M-DAS/MDAS-Drive_by_Wire/README.md

# MDAS-Drive_by_Wire
The drive-by-wire division of the University of Michigan-Dearborn Autonomous Shuttle.
