M-DAS/MDAS-Drive_by_Wire/PCB/v2.0/MDAS_Controller_V2.pdf

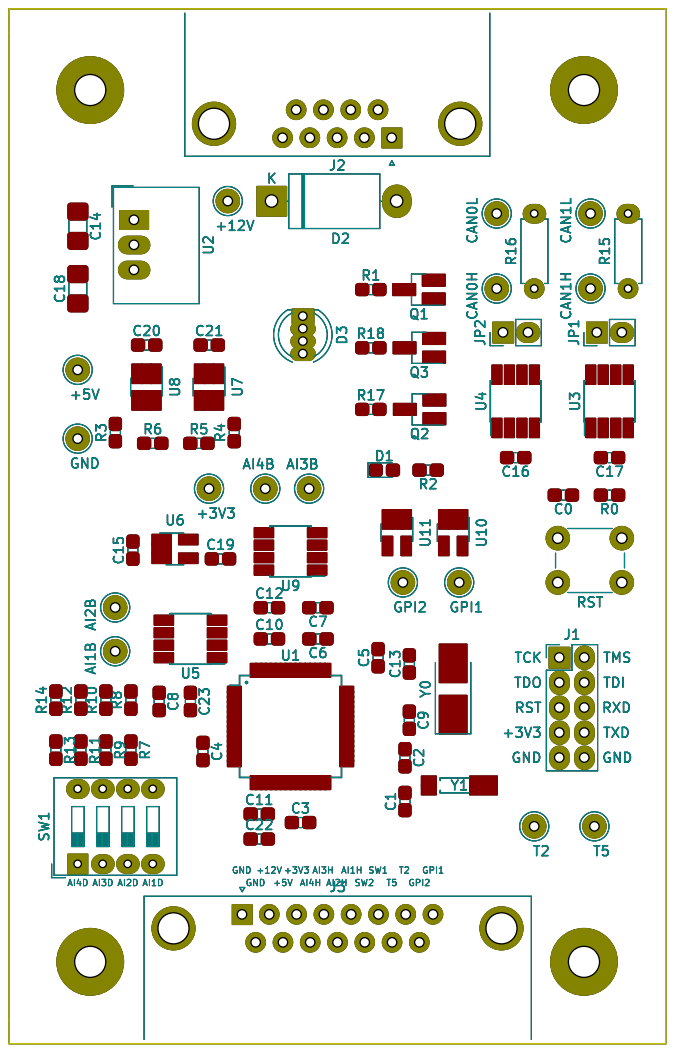
[picture p1: page 1]
