M-DAS/MDAS-Drive_by_Wire/PCB/v2.0/MDAS_Controller_V2.kicad_pcb

## KiCad design PCB/v2.0/MDAS_Controller_V2.kicad_pcb (2018-09-26)

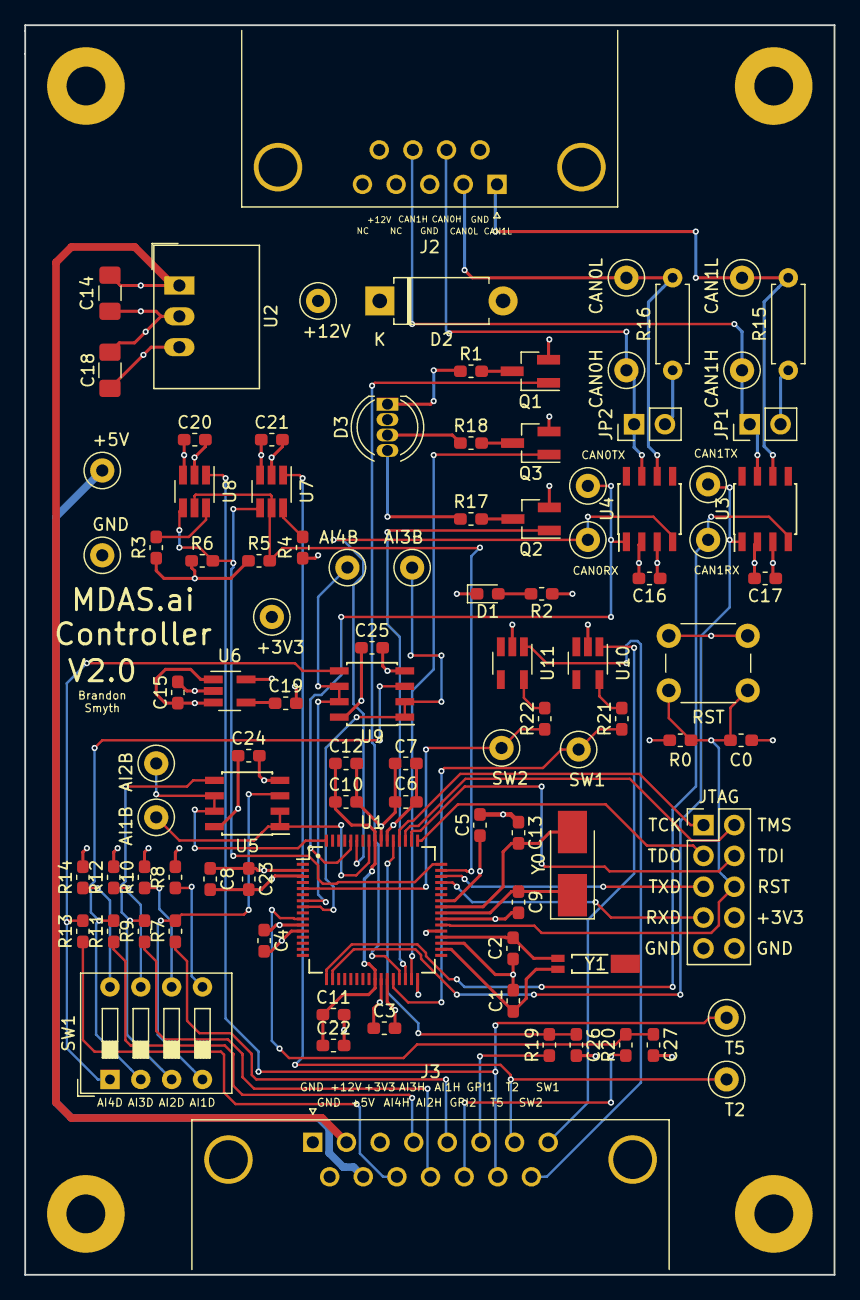
[picture p2: board MDAS_Controller_V2.kicad_pcb from above]

Board: 4 copper layers, 66.7 x 102.9 mm, 101 parts (0 on the bottom side), 69 nets.

Parts:
+3V3, +5V, +12V: TestPoint; TestPoint_Loop_D1.80mm_Drill1.0mm_Beaded
AI1B, AI2B, AI3B, AI4B: TestPoint; TestPoint_Loop_D1.80mm_Drill1.0mm_Beaded
C0, C3, C4, C5, C6, C10, C11, C16, C17, C20, C21, C24, C25: 0.1uF; C_0603_1608Metric_Pad1.05x0.95mm_HandSolder
C1, C2: 24pF; C_0603_1608Metric_Pad1.05x0.95mm_HandSolder
C7, C22: 2.2uF; C_0603_1608Metric_Pad1.05x0.95mm_HandSolder
C8, C12, C15: 1.0uF; C_0603_1608Metric_Pad1.05x0.95mm_HandSolder
C9, C13: 10pF; C_0603_1608Metric_Pad1.05x0.95mm_HandSolder
C14, C18: 10uF; C_1206_3216Metric_Pad1.42x1.75mm_HandSolder
C19, C23, C26, C27: 0.01uF; C_0603_1608Metric_Pad1.05x0.95mm_HandSolder
CAN0H, CAN0L, CAN0RX, CAN0TX, CAN1H, CAN1L, CAN1RX, CAN1TX: TestPoint; TestPoint_Loop_D1.80mm_Drill1.0mm_Beaded
D1: LED; LED_0603_1608Metric_Pad1.05x0.95mm_HandSolder
D2: TP6KE33A; D_DO-15_P10.16mm_Horizontal
D3: LED_RABG; LED_D5.0mm-4
GND: TestPoint; TestPoint_Loop_D1.80mm_Drill1.0mm_Beaded
J2: DB9_Male; DSUB-9_Male_Horizontal_P2.77x2.84mm_EdgePinOffset9.90mm_Hou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
J3: DB15_Male; DSUB-15_Male_Horizontal_P2.77x2.84mm_EdgePinOffset7.70mm_Ho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
JP1, JP2: Jumper_NC_Small; PinHeader_1x02_P2.54mm_Vertical
JTAG: JTAG; PinHeader_2x05_P2.54mm_Vertical
MH1, MH2, MH3, MH4: MountingHole_Pad; MountingHole_3.2mm_M3_Pad
Q1, Q2, Q3: DTC114E; SOT-23_Handsoldering
R0, R3, R4, R5, R6: 10k; R_0603_1608Metric_Pad1.05x0.95mm_HandSolder
R1, R2, R17, R18: 330; R_0603_1608Metric_Pad1.05x0.95mm_HandSolder
R7, R9, R11, R13: 11k; R_0603_1608Metric_Pad1.05x0.95mm_HandSolder
R8, R10, R12, R14: 21k; R_0603_1608Metric_Pad1.05x0.95mm_HandSolder
R15, R16: 120; R_Axial_DIN0207_L6.3mm_D2.5mm_P7.62mm_Horizontal
R19, R20, R21, R22: 1k; R_0603_1608Metric_Pad1.05x0.95mm_HandSolder
RST: SW_Push; SW_PUSH_6mm_H5mm
SW1: SW_DIP_x04; SW_DIP_SPSTx04_Slide_9.78x12.34mm_W7.62mm_P2.54mm
SW1#2, SW2: TestPoint; TestPoint_Loop_D1.80mm_Drill1.0mm_Beaded
T2, T5: TestPoint; TestPoint_Loop_D1.80mm_Drill1.0mm_Beaded
U1: TM4C123GH6PM; LQFP-64_10x10mm_P0.5mm
U2: R-78E5.0-0.5; Converter_DCDC_RECOM_R-78E-0.5_THT
U3, U4: SN65HVD232; SOIC-8_3.9x4.9mm_P1.27mm
U5, U9: OPA2333xxD; SOIC-8_3.9x4.9mm_P1.27mm
U6: TPS73633DBV; SOT-23-5_HandSoldering
U7, U8: MCP4725A2T-E_CH; SOT-23-6_Handsoldering
U10, U11: TPS70933DBVT; SOT-23-5_HandSoldering
Y0: 16MHz; Crystal_SMD_5032-2Pin_5.0x3.2mm_HandSoldering
Y1: 32.768kHz; ABRACON_AB26TRQ

Connections:
+3V3: +3V3.1, C3.1, C4.1, C5.1, C6.1, C7.1, C8.1, C16.1, C17.1, C23.1, C24.1, C25.1, J3.3, JTAG.8, R0.1, R2.1, U1.2, U1.11, U1.26, U1.37, U1.42, U1.54, U3.3, U4.3, U5.8, U6.5, U9.8
+5V: +5V.1, C15.1, C18.1, C20.1, C21.1, D3.2, J3.10, R3.1, R5.1, R6.1, U2.3, U6.1, U6.3, U7.3, U8.3
+12V: +12V.1, C14.1, D2.1, J2.9, J3.2, U2.1
AI1B: AI1B.1, U1.57, U5.1, U5.2
AI1H: J3.5, R7.1
AI2B: AI2B.1, U1.64, U5.6, U5.7
AI2H: J3.12, R9.1
AI3B: AI3B.1, U1.8, U9.1, U9.2
AI3H: J3.4, R11.1
AI4B: AI4B.1, U1.7, U9.6, U9.7
AI4H: J3.11, R13.1
CAN0H: CAN0H.1, J2.7, JP2.1, U4.7
CAN0L: CAN0L.1, J2.2, R16.2, U4.6
CAN0RX: CAN0RX.1, U1.59, U4.4
CAN0TX: CAN0TX.1, U1.60, U4.1
CAN1H: CAN1H.1, J2.8, JP1.1, U3.7
CAN1L: CAN1L.1, J2.1, R15.2, U3.6
CAN1RX: CAN1RX.1, U1.17, U3.4
CAN1TX: CAN1TX.1, U1.18, U3.1
GND: C0.2, C1.2, C2.2, C3.2, C4.2, C5.2, C6.2, C7.2, C8.2, C9.2, C10.2, C11.2, C12.2, C13.2, C14.2, C15.2, C16.2, C17.2, C18.2, C19.2, C20.2, C21.2, C22.2, C23.2, C24.2, C25.2, C26.2, C27.2, D1.1, D2.2, GND.1, J2.3, J2.6, J3.1, J3.9, JTAG.9, JTAG.10, Q1.2, Q2.2, Q3.2, R4.1, R8.2, R10.2, R12.2, R14.2, RST.1, U1.3, U1.12, U1.27, U1.32, U1.35, U1.39, U1.55, U2.2, U3.2, U4.2, U5.4, U6.2, U7.2, U8.2, U9.4, U10.2, U11.2
GPI1: J3.6, R19.1
GPI2: J3.13, R20.1
LED_B: Q3.1, U1.31
LED_G: Q2.1, U1.30
LED_R: Q1.1, U1.29
unnamed: C1.1, U1.34, Y1.1
unnamed: C2.1, U1.36, Y1.2
unnamed: C9.1, U1.40, Y0.1
unnamed: C10.1, C11.1, C12.1, C22.1, U1.25, U1.56
unnamed: C13.1, U1.41, Y0.2
unnamed: C19.1, U6.4
unnamed: C26.1, R19.2, U1.53
unnamed: C27.1, R20.2, U1.10
unnamed: D1.2, R2.2
unnamed: D3.1, R1.1
unnamed: D3.3, R18.1
unnamed: D3.4, R17.1
unnamed: JP1.2, R15.1
unnamed: JP2.2, R16.1
unnamed: Q1.3, R1.2
unnamed: Q2.3, R17.2
unnamed: Q3.3, R18.2
unnamed: R3.2, U8.6
unnamed: R4.2, U7.6
unnamed: R7.2, SW1.4, U5.3
unnamed: R8.1, SW1.5
unnamed: R9.2, SW1.3, U5.5
unnamed: R10.1, SW1.6
unnamed: R11.2, SW1.2, U9.3
unnamed: R12.1, SW1.7
unnamed: R13.2, SW1.1, U9.5
unnamed: R14.1, SW1.8
unnamed: R21.2, U10.5
unnamed: R22.2, U11.5
RST: C0.1, JTAG.6, R0.2, RST.2, U1.38
RXD: JTAG.7, U1.45
SCL: R5.2, U1.47, U7.5, U8.5
SDA: R6.2, U1.48, U7.4, U8.4
SW1: J3.8, U10.1
SW1P: R21.1, SW1#2.1, U1.28
SW2: J3.15, U11.1
SW2P: R22.1, SW2.1, U1.5
T2: J3.7, T2.1, U7.1
T5: J3.14, T5.1, U8.1
TCK: JTAG.1, U1.52
TDI: JTAG.4, U1.50
TDO: JTAG.3, U1.49
TMS: JTAG.2, U1.51
TXD: JTAG.5, U1.46
