M-DAS/MDAS-Drive_by_Wire/PCB/v1.0/MDAS_Controller_V1.brd

## EAGLE design PCB/v1.0/MDAS_Controller_V1.brd (2018-07-30, an earlier design)

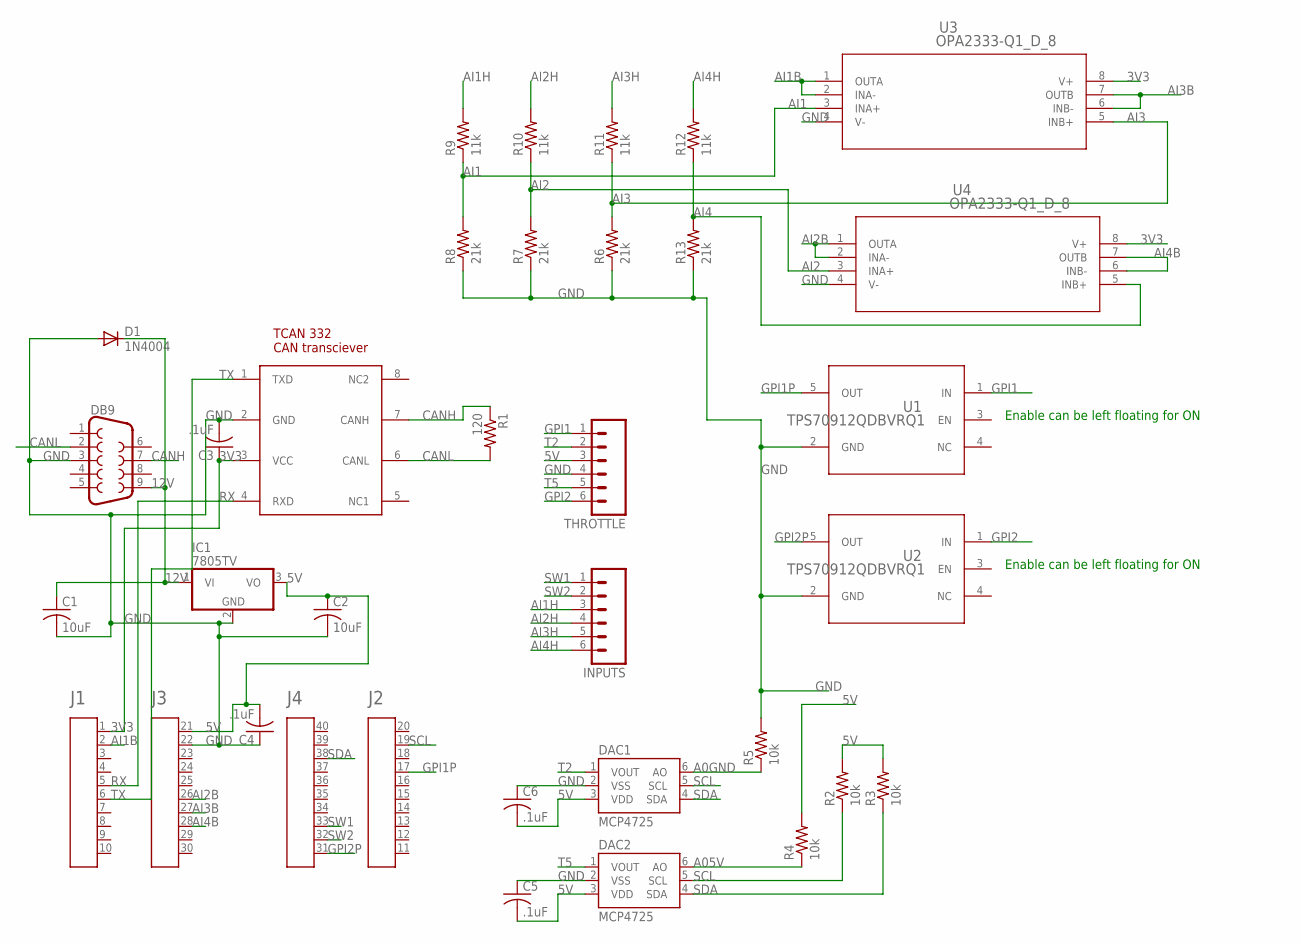
[picture p3: schematic MDAS_Controller_V1.sch]

Parts:
A1: HEADER4X10-BOOSTERPACK; 4X10-BOOSTERPACK
C1, C2: 10uF; C1206K
C3, C4, C5, C6: .1uF; C0603
CAN_TRANSCIEVER: TCAN332; SOIC127P600X172-8N
D1: 1N4004; DO41-10
DAC1, DAC2: MCP4725; SOT23-6
DB9: DB9FEMALE; DB9
IC1: 7805TV; TO220V
INPUTS: M06SMD-1MM; 1X06-1MM
R1: 120; 0207/10
R2, R3, R4, R5: 10k; 0603-RES
R6, R7, R8, R13: 21k; R0603
R9, R10, R11, R12: 11k; R0603
THROTTLE: M06SMD-1MM; 1X06-1MM
U1, U2: TPS70912QDBVRQ1; DBV0005A_N
U3, U4: OPA2333-Q1_D_8; D8

Connections:
3V3: A1.1, C3.1, CAN_TRANSCIEVER.3 (VCC), U3.8 (V+), U4.8 (V+)
5V: A1.21, C2.1, C4.2, C5.2, C6.2, DAC1.3 (VDD), DAC2.3 (VDD), IC1.3 (VO), R2.2, R3.2, R4.2, THROTTLE.3
12V: C1.1, D1.C, DB9.9, IC1.1 (VI)
A0GND: DAC1.6 (AO), R5.1
A05V: DAC2.6 (AO), R4.1
AI1: R8.2, R9.1, U3.3 (INA+)
AI1B: A1.2, U3.1 (OUTA), U3.2 (INA-)
AI1H: INPUTS.3, R9.2
AI2: R7.2, R10.1, U4.3 (INA+)
AI2B: A1.26, U4.1 (OUTA), U4.2 (INA-)
AI2H: INPUTS.4, R10.2
AI3: R6.2, R11.1, U3.5 (INB+)
AI3B: A1.27, U3.6 (INB-), U3.7 (OUTB)
AI3H: INPUTS.5, R11.2
AI4: R12.1, R13.2, U4.5 (INB+)
AI4B: A1.28, U4.6 (INB-), U4.7 (OUTB)
AI4H: INPUTS.6, R12.2
CANH: CAN_TRANSCIEVER.7 (CANH), DB9.7, R1.1
CANL: CAN_TRANSCIEVER.6 (CANL), DB9.2, R1.2
GND: A1.22, C1.2, C2.2, C3.2, C4.1, C5.1, C6.1, CAN_TRANSCIEVER.2 (GND), D1.A, DAC1.2 (VSS), DAC2.2 (VSS), DB9.3, IC1.2 (GND), R5.2, R6.1, R7.1, R8.1, R13.1, THROTTLE.4, U1.2 (GND), U2.2 (GND), U3.4 (V-), U4.4 (V-)
GPI1: THROTTLE.1, U1.1 (IN)
GPI1P: A1.17, U1.5 (OUT)
GPI2: THROTTLE.6, U2.1 (IN)
GPI2P: A1.31, U2.5 (OUT)
RX: A1.5, CAN_TRANSCIEVER.4 (RXD)
SCL: A1.19, DAC1.5 (SCL), DAC2.5 (SCL), R2.1
SDA: A1.38, DAC1.4 (SDA), DAC2.4 (SDA), R3.1
SW1: A1.33, INPUTS.1
SW2: A1.32, INPUTS.2
T2: DAC1.1 (VOUT), THROTTLE.2
T5: DAC2.1 (VOUT), THROTTLE.5
TX: A1.6, CAN_TRANSCIEVER.1 (TXD)

Notes on the sheet:
Enable can be left floating for ON

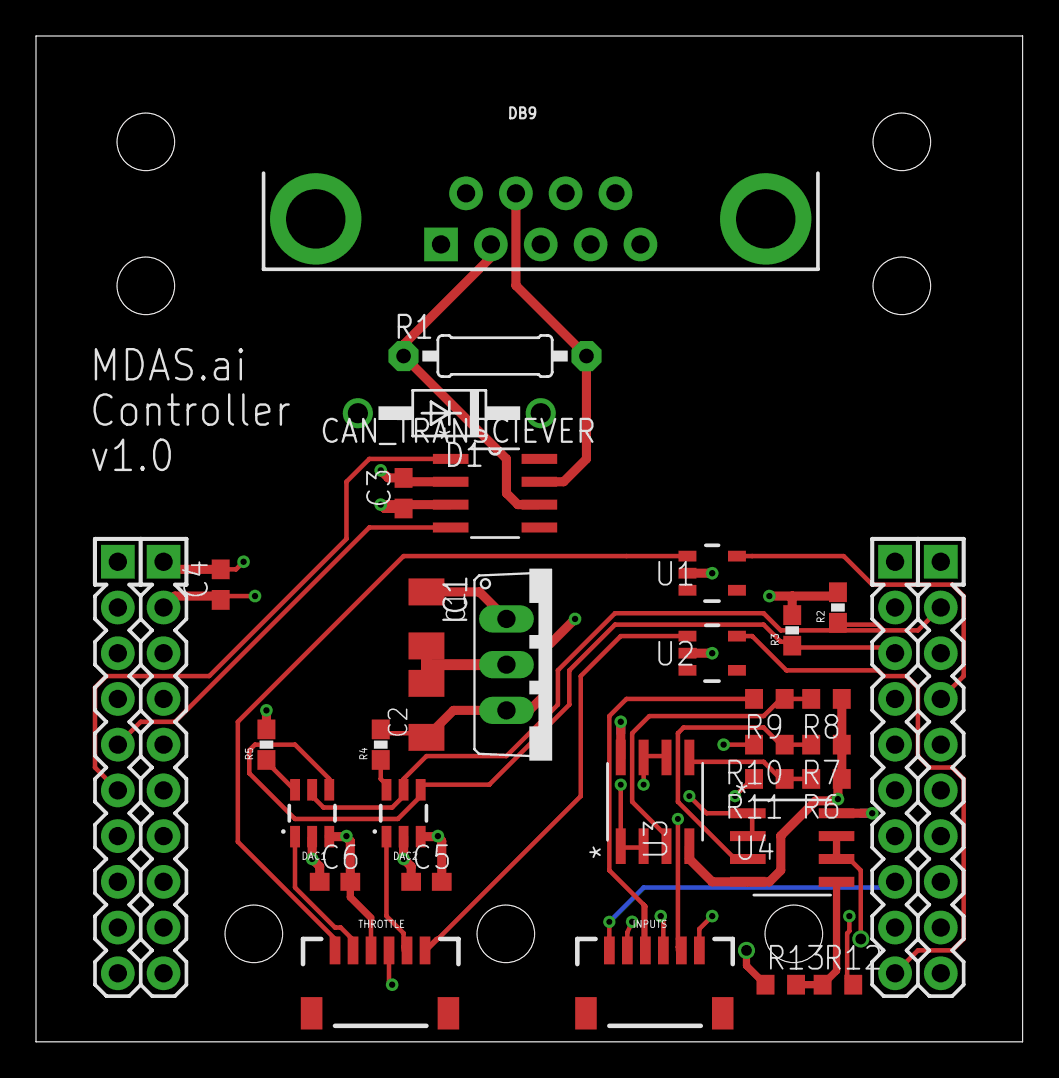
[picture p4: board MDAS_Controller_V1.brd from above]

Board: 4 copper layers, 54.8 x 55.9 mm, 32 parts (0 on the bottom side), 32 nets.
