M-DAS/MDAS-Drive_by_Wire/Joystick/DriveByWireIO.c

#define PART_TM4C123GH6PM 1;

#include <stdint.h>
#include <stdbool.h>

#include "Globals_and_Defines.h"
#include "initialization.h"

#include "Controller_Inputs.h"

#include "Switches_PORTF.h"
#include "Linear_Actuator.h"
#include "Steering_Actuator.h"
#include "Throttle.h"



//Steering wheel scaling
int32_t calc_steering_pos(uint32_t position)
{
	int32_t scaled_position;
	position = (((position + 2048)&0x00000FFF)<<20); 
	scaled_position = position;
	scaled_position = scaled_position/131072;
	scaled_position = (scaled_position*100)+360000;
	return scaled_position;
}

//Throttle scaling
uint32_t calc_throttle_pos(uint32_t position)
{
	uint32_t digital_pot_position;
	digital_pot_position = position;
	return digital_pot_position;
}

//Linear actuator scaling
uint32_t calc_linear_act_pos(uint32_t position)
{
	return position;
}


void DriveByWireIO(void)
{
	//ADC_values 3 element array
	//ADC_values[0] steering wheel
	//ADC_values[1] throttle
	//ADC_values[2] brake
	uint32_t ADC_values[3];
	int32_t steering_pos;
	uint32_t throttle_pos, linear_act_pos;
	
	get_contrlr_inputs(ADC_values);
	
	steering_pos = calc_steering_pos(ADC_values[0]);
	throttle_pos = calc_throttle_pos(ADC_values[1]);
	linear_act_pos = calc_linear_act_pos(ADC_values[2]);
	
	moveto_steering_act(steering_pos);
	moveto_throttle(throttle_pos);
	//moveto_lin_act(linear_act_pos);
}
