M-DAS/MDAS-Drive_by_Wire/Throttle/CAN_comm.c

#define PART_TM4C123GH6PM 1;

#include <stdint.h>
#include <stdbool.h>
#include "inc/tm4c123gh6pm.h"
#include "inc/hw_memmap.h"
#include "inc/hw_types.h"
#include "driverlib/sysctl.h"
#include "driverlib/interrupt.h"
#include "driverlib/gpio.h"
#include "driverlib/timer.h"
#include "driverlib/pin_map.h"
#include "driverlib/can.h"

#include "Globals_and_Defines.h"
	
uint8_t data_array[3];

void CAN_Setup(void)
{
	//CAN message object
	tCANMsgObject sMsgObjectRx;

	//Set system clock to 40MHz
	SysCtlClockSet(SYSCTL_SYSDIV_5|SYSCTL_USE_PLL|SYSCTL_XTAL_16MHZ|SYSCTL_OSC_MAIN);

	//Enable PORTE
	SysCtlPeripheralEnable(SYSCTL_PERIPH_GPIOE);
	while(!SysCtlPeripheralReady(SYSCTL_PERIPH_GPIOE))
	{}

	// Configure the GPIO pin muxing to select CAN0 functions for these pins.
	// This step selects which alternate function is available for these pins.
	GPIOPinConfigure(GPIO_PE4_CAN0RX);
	GPIOPinConfigure(GPIO_PE5_CAN0TX);

	//Configure the pins for CAN
	GPIOPinTypeCAN(GPIO_PORTE_BASE, GPIO_PIN_4 | GPIO_PIN_5);

	
	// Enable the CAN0 module.
	SysCtlPeripheralEnable(SYSCTL_PERIPH_CAN0);
	while(!SysCtlPeripheralReady(SYSCTL_PERIPH_CAN0))
	{}

	// Reset the state of all the message objects and the state of the CAN
	// module to a known state.
	CANInit(CAN0_BASE);

		
	// Configure the controller for 250 Kbit operation.
	CANBitRateSet(CAN0_BASE, SysCtlClockGet(), 250000);
	
	//Set the priority for the Update timer as priority 1
	IntPrioritySet(INT_CAN0, 0x20);
	
	//Enable interrupts for CAN0
	CANIntEnable(CAN0_BASE, CAN_INT_MASTER);
	IntEnable(INT_CAN0);

	//Set CAN0 to silent test mode
	//CAN0_CTL_R |= CAN_CTL_TEST;
	//CAN0_TST_R |= CAN_TST_SILENT;
	
	//Start CAN0 peripheral
	CANEnable(CAN0_BASE);
	

	// Configure a receive object.
	sMsgObjectRx.ui32MsgID = throttle_board_address;
	sMsgObjectRx.ui32MsgIDMask = 0x012EEEEE;
	sMsgObjectRx.ui32Flags = MSG_OBJ_RX_INT_ENABLE | MSG_OBJ_USE_ID_FILTER;
	sMsgObjectRx.ui32MsgLen = 3;
	CANMessageSet(CAN0_BASE, 2, &sMsgObjectRx, MSG_OBJ_TYPE_RX);
}







void CAN0_Handler(void)
{
	uint32_t int_status, CAN_status;
	tCANMsgObject sMsgObjectRx;
	sMsgObjectRx.pui8MsgData = data_array;
	

	//get interrupt status
	int_status = CANIntStatus(CAN0_BASE, CAN_INT_STS_CAUSE);  
	//get CAN status
	CAN_status = CANStatusGet(CAN0_BASE, CAN_STS_CONTROL);
	
	
	if (int_status == 0x2)   //interrupt was generated by receive object
	{
		CANMessageGet(CAN0_BASE, 2, &sMsgObjectRx, true);   //get received data
		g_new_CAN_data = true;
		if(sMsgObjectRx.ui32MsgID != 0x12EEEEE) return;
		if (data_array[0] == 0x22)
		{
			g_throttle_mode = true;
			g_CAN_throttle_pos = 0x00000000;
			g_CAN_throttle_pos |= data_array[1];
			g_CAN_throttle_pos = g_CAN_throttle_pos<<8;
			g_CAN_throttle_pos = g_CAN_throttle_pos | data_array[2];
			
			
			
			//g_CAN_throttle_pos = data_array[1];
		}
		else
		{
			g_throttle_mode = false;
		}
	}
}
