M-DAS/MDAS-Drive_by_Wire/Throttle/CAN_comm.h

#ifndef _CANCOMM_H_
#define _CANCOMM_H_

/***********************
* Includes             *
***********************/
#include <stdint.h>
#include <stdbool.h>


/***********************
* Public Types         *
***********************/

/***********************
* Public Macros        *
***********************/


/***********************
* Public Defines       *
***********************/


/***********************
* Public Constants     *
***********************/


/***********************
* Public Variables     *
***********************/
extern uint8_t data_array[3];

/***********************
* Public Functions     *
***********************/
void CAN_Setup(void);


#endif /* _CANCOMM_H_ */
