M-DAS/MDAS-Drive_by_Wire/Joystick/Globals_and_Defines.c

/***********************
* Includes             *
***********************/
#include <stdint.h>
#include <stdbool.h>


/***********************
* Type Definitions     *
***********************/

/***********************
* Macros               *
***********************/
   
/***********************
* Defines              *
***********************/

/***********************
* Constants            *
***********************/

/***********************
* Calibrations         *
***********************/

/***********************
* Global Variables     *
***********************/

//Flag for tick timer.   
//Timer ISR sets to true.
//Scheduler sets to false 
bool g_tick_flag = false;

//Flag for starting drive by wire.   
//GPIO PORTF ISR sets to true.
//Scheduler sets to false 
bool g_start_flag = false;

//Flag for stopping drive by wire.   
//GPIO PORTF ISR sets to true.
//Scheduler sets to false 
bool g_stop_flag = false;



/***********************
* File Scope Variables *
***********************/

/***********************
* Function Prototypes  *
***********************/


/***********************
* Function Definitions *
***********************/
