M-DAS/MDAS-Drive_by_Wire/(commit log)

2018-05-08 Folder or the braking actuator
2018-05-08 Steering Actuator files
2018-06-12 Changes to Steering Actuation
    Took the derivative between two torques and established a torque threshold based on the result. If the threshold was passed, it would change to a state that would keep the position of the wheels and steering the same while giving the user full control. Untested as of now, so purely theoretical at this time.
2018-07-09 My code after like 28 Days
    Steering stuff
2018-07-10 Added dac.c skeleton
    Missing scaling function. Will need scaling equation from throttle voltage range.
    [dac.c]
2018-07-10 Throttle Main Written
    Throttle Main has been written to the point that I only need the "write to DAC" functions and it''ll be good to be programmed.
2018-07-10 Fixed Typo
    Fixed typo << 1 vs << 2
    [dac.c]
2018-07-11 Changed Masking Logic
    Reversed logic from last iteration to only update data when the ID is found.
    [main.c]
2018-07-23 Some throttle stuff
    The stuff I contributed to the main so that I can get Ben's baller helper function code.
2018-07-23 More throttle stuff
    I forgot to save it
2018-07-28 Finalized ADC, DAC functions
    ADC to percent still needs to be scaled to percent. Equation is currently missing. Drive_by_Wire.c will need to be updated to reflect DAC instead of digital potentiometers.
    [Drive_by_Pedal.c, dac.c, dac.h, initialization.c]
2018-07-30 added v1.0 PCB files
    [MDAS_Controller_V1.brd, MDAS_Controller_V1.sch, MDAS_Controller_V1_test.sch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]
2018-07-30 Fixed ADC input scaling
    Scaled ADC input to 0-100 percent
    [Drive_by_Pedal.c]
2018-08-01 Reading over CAN
    Reads in messages over CAN and is now able to change states. As far as hardware goes, PCB has bad wire connection. Please remember to check.
2018-09-07 Add V2 Board to Repo
    [MDAS_Controller_V2-B.Cu.gbr, MDAS_Controller_V2-B.Mask.gbr, MDAS_Controller_V2-B.SilkS.gbr, MDAS_Controller_V2-Edge.Cuts.gbr, MDAS_Controller_V2-F.Cu.gbr, MDAS_Controller_V2-F.Mask.gbr, MDAS_Controller_V2-F.SilkS.gbr, MDAS_Controller_V2-GND.gbr]
2018-09-23 Redesign routing
    [MDAS_Controller_V2-B.Cu.gbr, MDAS_Controller_V2-B.Mask.gbr, MDAS_Controller_V2-B.SilkS.gbr, MDAS_Controller_V2-Edge.Cuts.gbr, MDAS_Controller_V2-F.Cu.gbr, MDAS_Controller_V2-F.Mask.gbr, MDAS_Controller_V2-F.SilkS.gbr, MDAS_Controller_V2-GND.gbr]
2018-09-26 Minor changes before Hughes manufactures
    [MDAS_Controller_V2-B.Cu.gbr, MDAS_Controller_V2-B.Mask.gbr, MDAS_Controller_V2-B.SilkS.gbr, MDAS_Controller_V2-Edge.Cuts.gbr, MDAS_Controller_V2-F.Cu.gbr, MDAS_Controller_V2-F.Mask.gbr, MDAS_Controller_V2-F.SilkS.gbr, MDAS_Controller_V2-GND.gbr]
